AhmedMaher06/Basics-of-MCTA-Project/Mechanical/Shooting Mechanism/Shooting Mechanism.png

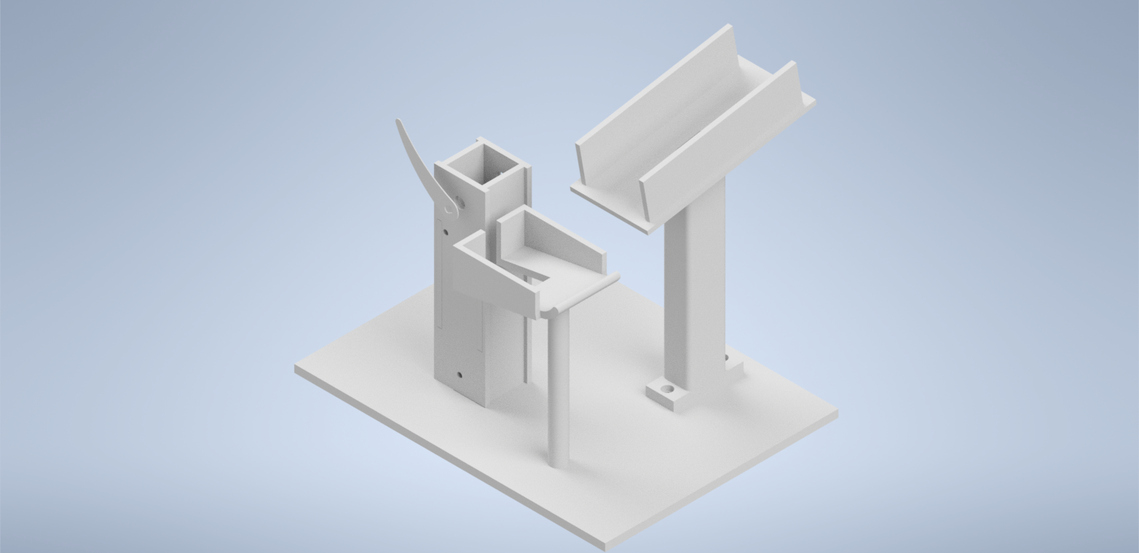
Mechanical/Shooting Mechanism/Shooting Mechanism.png
