AhmedMaher06/Basics-of-MCTA-Project/Docs/Gantt-Chart.png

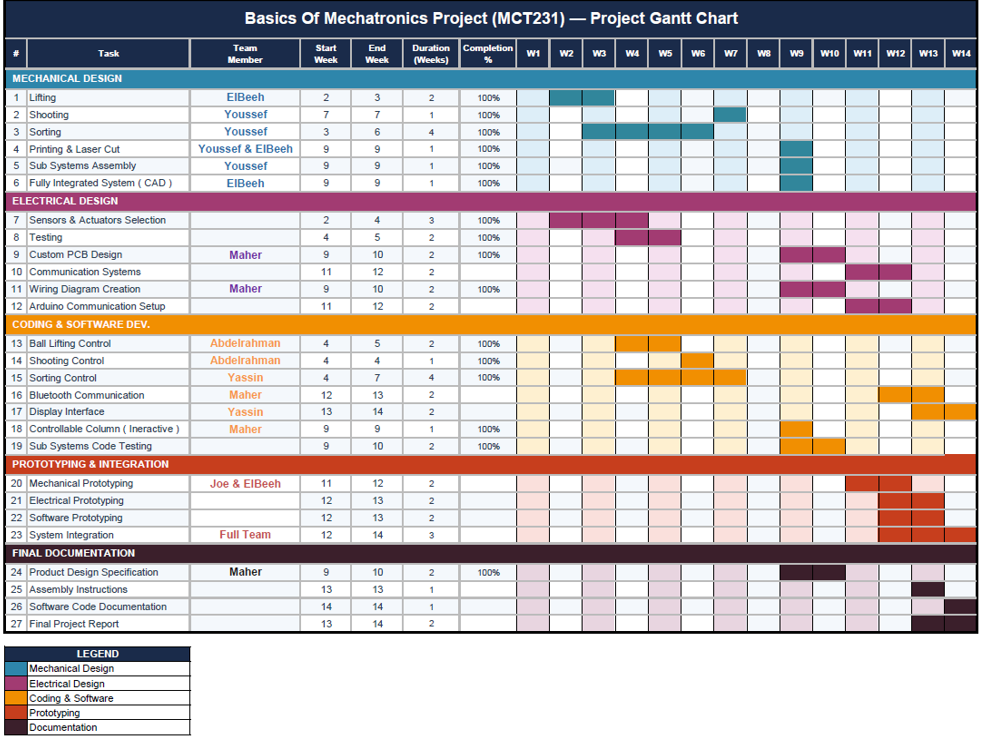
Docs/Gantt-Chart.png
