AhmedMaher06/Basics-of-MCTA-Project/README.md

# basics-project-
project basics of mechatronics
