AhmedMaher06/Basics-of-MCTA-Project/Docs/Final Report Basics Of MCTA.pdf

MCT231: Basics of Mechatronics

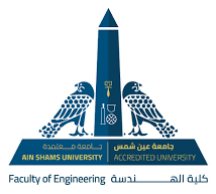
[picture p14: figure]

## MCT231: Basics of Mechatronics

# Team 7

Team Member | Student ID
Youssef Ibrahim | 24P0015
Abdelrhman Essam | 24P0045
Abdelrahman ElBeeh | 24P0114
Ahmed Maher | 24P0004
Yassin Ibrahim | 24P0162

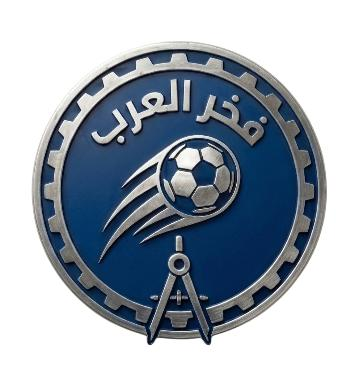
[picture p15: figure]

## Table of Contents

## Table of Figures

## 1. Introduction

This project presents a mechatronics-based interactive game designed for children, combining mechanical systems, control, and basic physics principles. The system uses a ball-based mechanism where balls are launched, lifted, and guided through a structured path. The objective of the game is to engage users in a fun and educational way while introducing them to concepts such as motion, control, and decision-making.

The game incorporates multiple subsystems including a shooting mechanism, a lifting mechanism, and a sorting/scoring section. These elements work together to create a dynamic and interactive environment that enhances both entertainment and learning.

## Project Overview & Concept

The project is a smart mechanical game that uses two types of balls:

- White balls → increase the player's score
- Black balls → decrease the player's score

The system begins with a feeding unit that releases balls into a shooting mechanism, which launches the ball along a defined path. The ball is then transferred through a lifting mechanism that elevates it to a higher level, allowing it to continue its motion through the system.

At the final stage, the ball reaches a decision area controlled by a movable slider (cylinder) operated by the player. The player must adjust the slider position to guide the ball into the desired path based on its colour: directing a white ball to the correct slot increases the score, while directing a black ball incorrectly reduces the score. This introduces an element of timing, control, and quick decision-making, making the game both challenging and engaging.

## Concept and Objectives

The main concept of the project is to integrate mechanical motion with user interaction to create a responsive system. The objectives include:

- Designing a fully integrated mechatronic system
- Demonstrating projectile motion and ball dynamics

- Developing mechanical mechanisms (shooting, lifting, guiding)
- Enhancing user interaction and reflex-based decision-making
- Creating an educational and entertaining game for children

## 2. User Research

## Research Methodology

Before finalising the toy concept, the team conducted a structured user research phase to validate the design direction. The research aimed to identify what children aged 2–10 and their parents value most in an interactive toy, and to understand the competitive landscape of educational mechatronic toys.

## Competitive Analysis

Existing toys included marble-run sets, pinball machines, and simple robotic kits. Key gaps identified:

- Most toys lack real-time scoring feedback.
- Few toys combine a colour-sensing decision mechanic with physical launching.
- Higher-end STEM toys exceed the target price point for most families.
These findings directly shaped the final concept: an affordable, colour-sorting ball game with a live score display, enclosed wiring, and no small detachable parts.

## 3. Design Challenge

The central design challenge was to create a mechatronic toy that is simultaneously safe for young children, educationally meaningful, mechanically reliable, and manufacturable within a budget of approximately 14,000 L.E.

## Key Constraints

- Safety: no exposed electrical contacts, no sharp corners, ball diameter large enough to prevent choking (≥ 30 mm).
- Size: overall footprint ≤ 100 cm × 100 cm, height ≤ 80 cm.
- Cost: primary structure from 3D-printed PLA and laser-cut plywood.
- Complexity: must be understandable and maintainable by a non-specialist adult.
- Durability: designed to survive repeated use and occasional impacts from young children.

## Identified Trade-offs

The team had to balance several competing demands throughout the design process:

- Sorting speed vs. detection accuracy: faster movement of the slider increases excitement but reduces the window for the IR to read the ball correctly.
- Compactness vs. mechanism clearance: a smaller footprint limits the travel length available for the lifting screw and the projectile range of the shooting arm.
- Motor power vs. noise: higher-torque motors are noisier, which may disturb younger children or parents.
- 3D-print resolution vs. print time: finer prints give better fitment but significantly increase fabrication time.

## 4. Ideation

## Ideation Process Overview

The team used a structured diverge-then-converge approach to idea generation. Four main techniques were employed: mind mapping, mood boarding and a weighted decision matrix.

## Mind Map

Starting from the central theme 'interactive children's toy', the team branched out into four domains: Mechanisms (shooting, lifting, sorting, guiding), Electronics (sensors, microcontrollers, actuators, displays), Interaction (player input, feedback, scoring), and Safety (materials, enclosures, edge treatment). Each domain was further expanded to individual components and ideas before being pruned by feasibility.

## Mood Board

Visual references were collected from existing ball-track toys, pinball machines, factory conveyor systems, and colorful classroom learning tools. The mood board established the design language: rounded forms, bold primary colors on a dark navy/green background, visible mechanical motion, and clear score displays.

## Decision Matrix

The final concept selection used a weighted matrix scoring each concept on: Safety (30%), Educational Value (25%), Feasibility (25%), and Engagement (20%). This concept scored highest overall (4.1/5), confirming the team's preferred direction.

## 5. Toy Description and Functionality

## 5.1 Mechanical Elements

The toy consists of three primary mechanical subsystems: the lifting mechanism, the shooting mechanism, and the sorting/guiding mechanism. All structural components are 3D-printed in PLA or laser-cut from 6 mm plywood.

Lifting Mechanism – Archimedes Screw

A helical screw (length 400 mm, outer diameter 100 mm, pitch 45 mm) transports balls from the base collection area up to the shooter entry point. The screw is driven by a DC yellow motor (stall torque 0.08–0.15 Nm). Actuator sizing confirmed the required motor torque of 0.03 Nm, well within the motor's capability. T_RMS was calculated at 0.0202 Nm for a 7-second lift cycle.

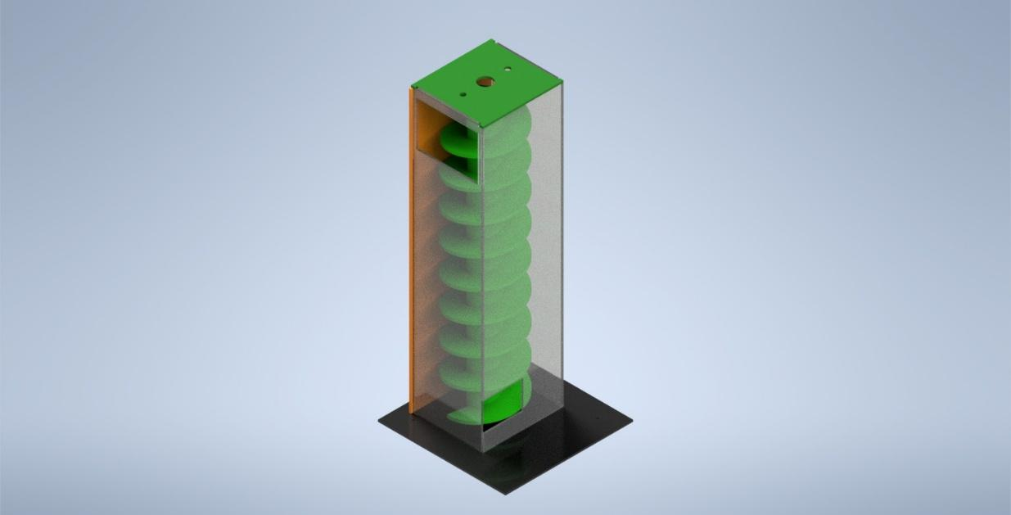
[picture p16: figure]

Figure 1 – Archimedes Screw Lifting Mechanism (Autodesk Inventor)

Shooting Mechanism – Rotating Arm

A 54 mm rotating arm (mass 3 g) is driven by a DC motor through a 180° swing in 0.2 s. The arm strikes the ball (mass 7 g, diameter 38 mm) at its tip, imparting a launch velocity of 1.13 m/s at 20° elevation. Projectile calculations give a range of 84 mm and a maximum height of 7.6 mm. Required Tm = 2.01 × 10⁻³ Nm; T_RMS = 1.17 × 10⁻³ Nm.

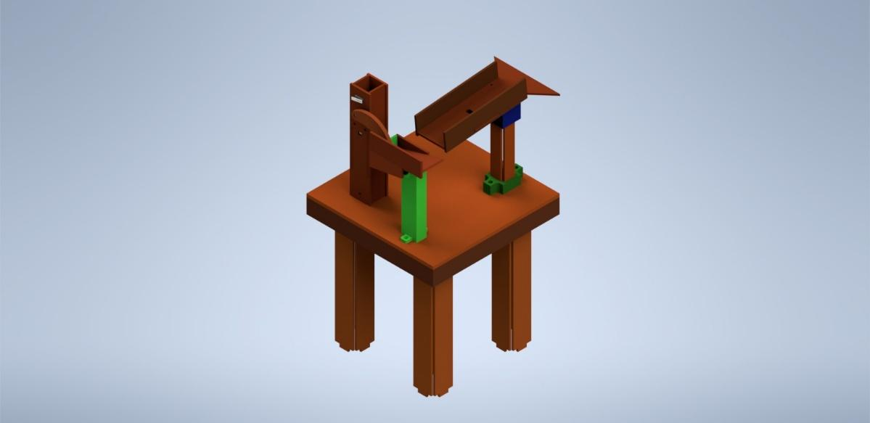
[picture p17: figure]

Figure 2 – Shooting Arm Mechanism (Autodesk Inventor)

Sorting / Guiding Mechanism – Movable Slider

A rack-and-pinion system (rack mass 4 g, travel 130 mm, pinion pitch radius 6 mm, 12 teeth) moves the decision slider horizontally in 2 s. A stepper motor provides precise positional control driven by the joystick input. T_RMS = 0.0012 Nm, well within the stepper's rated output. The slider directs each incoming ball to either a 'score' slot or a 'miss' slot based on the player's reaction to the ball's colour.

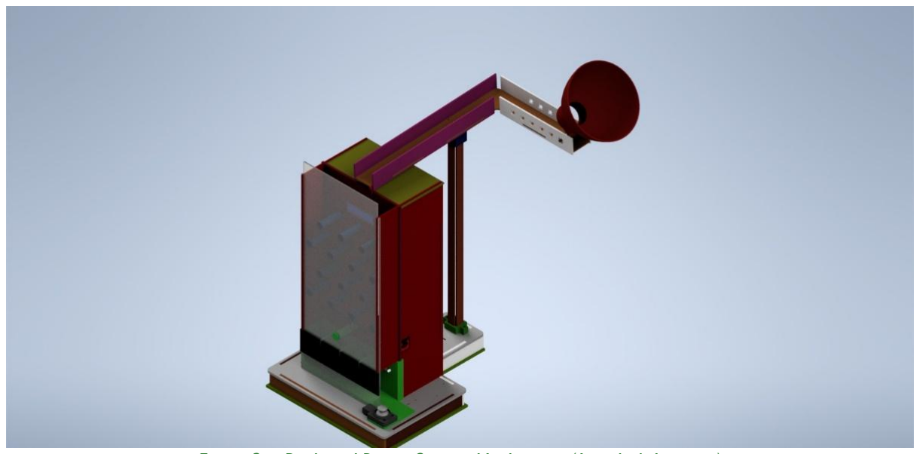
[picture p18: figure]

Figure 3 – Rack-and-Pinion Sorting Mechanism (Autodesk Inventor)

Full CAD Assembly

The complete 3D assembly was modelled in Autodesk Inventor, with overall dimensions of 94.5 cm (W) × 70 cm (L) × 72 cm (H). All mechanisms were verified for clearance and assembly fitment within the toy enclosure.

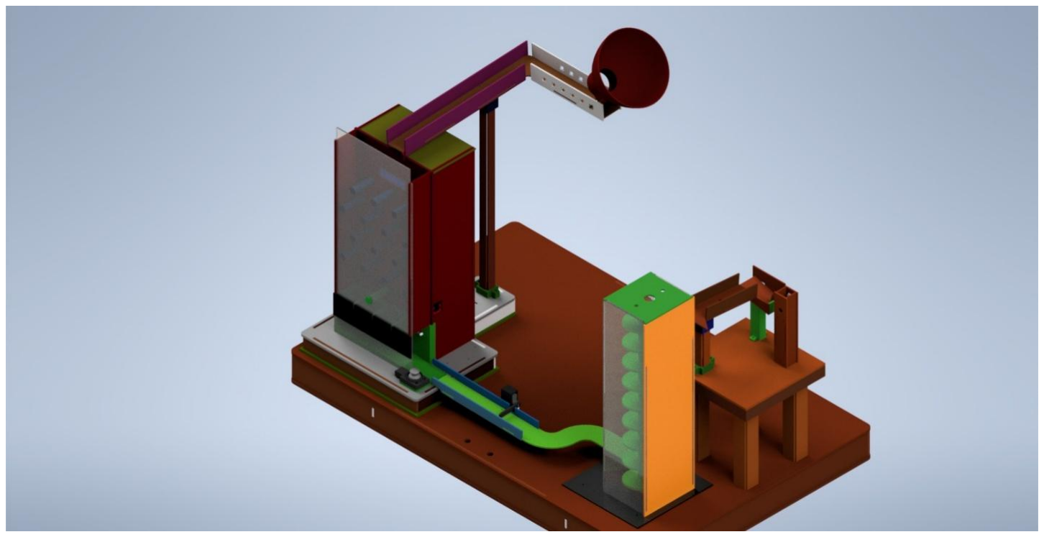
[picture p19: figure]

Figure 4 – Full System CAD Assembly (Autodesk Inventor)

## 5.2 Electrical and Control Elements

The electrical system is built around two Arduino microcontrollers communicating via a serial link. One Arduino manages the sensor inputs and shooting/lifting control; the other handles the sorting logic, display, and Bluetooth communication.

Sensor System

IR sensors (operating at 3.3–5 V, 20 mA) are placed at three critical points: (1) at the screw entry to trigger lifting, (2) at the shooter entry to confirm ball readiness, and (3) at the colour detection zone before the slider. The colour sensor distinguishes white from black balls by comparing reflected IR intensity against a threshold.

Motor Control & Wiring

Each DC motor is driven via an H-bridge driver.

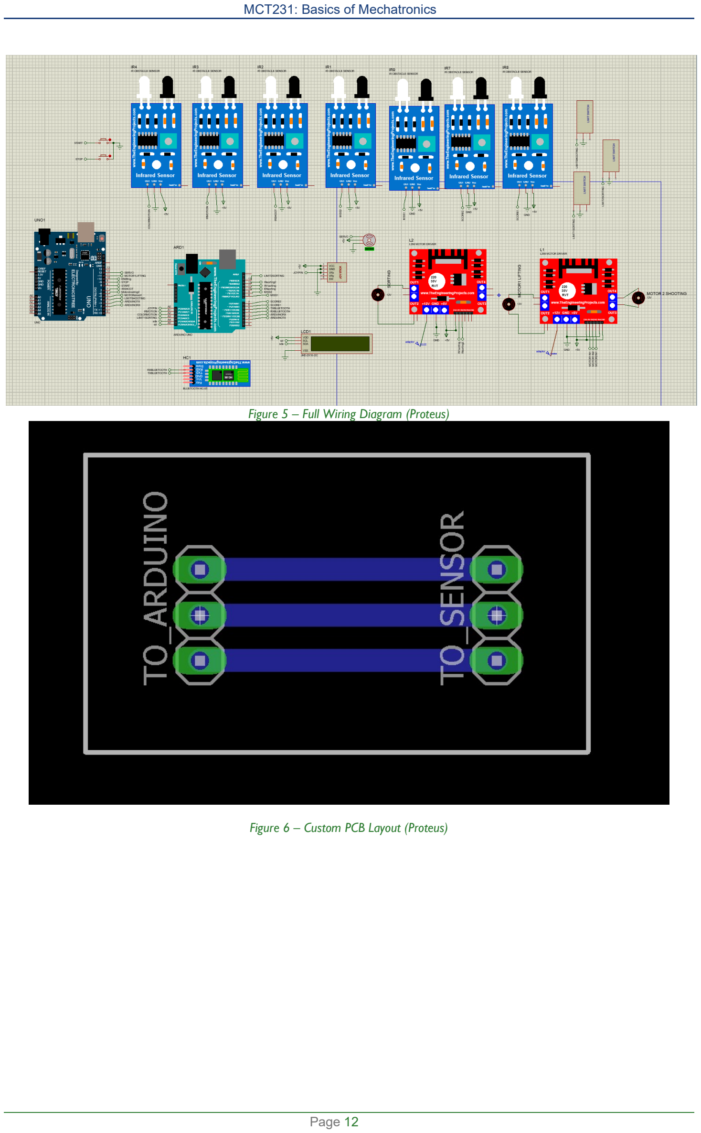
[picture p20: page 12]

Figure 5 – Full Wiring Diagram (Proteus)

Figure 6 – Custom PCB Layout (Proteus)

Block Diagram

The system block diagram illustrates the signal flow from sensors through the Arduinos to each actuator and the display. Bluetooth communication allows an optional mobile app to display real-time scores.

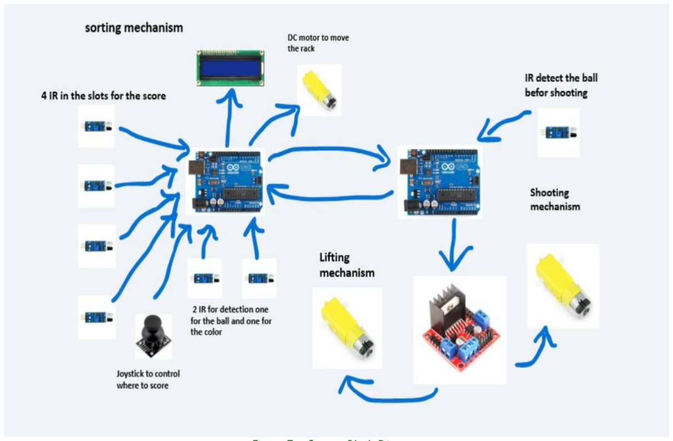
[picture p21: figure]

Figure 7 – System Block Diagram

## 6. Safety Considerations

The toy has been designed in compliance with general child product safety guidelines applicable to toys for children aged 2–10. The following specific design decisions ensure a safe user experience:

## Mechanical Safety

- All external surfaces are rounded with fillets ≥ 3 mm; no sharp edges or protruding fasteners are accessible to a child.
- Ball diameter is 30 mm — well above the 3D choke-hazard threshold of 31.7 mm for children under 3 (borderline; a slightly larger ball is recommended for the under-3 segment).
- Maximum ball launch velocity is 1.13 m/s — insufficient to cause injury on skin contact at the tested range.
- The Archimedes screw is fully enclosed within a transparent polycarbonate tube to prevent finger insertion during operation.

## Electrical Safety

- All wiring is routed internally and secured with cable ties; no bare conductors are accessible from outside the housing.
- All electrical components are housed.
- The operating voltage is 12 V DC supplied by a wall adapter; no mains-level voltages are present inside the toy.
- PCB safety circuits prevent motor overload and short-circuit conditions.

## Material Safety

- PLA plastic (used for 3D-printed parts) is biodegradable and non-toxic.
- Laser-cut plywood edges are sanded and sealed to prevent splinters.

## 7. Educational Impact

The toy is designed to develop a range of cognitive and physical skills appropriate for children aged 2–10, while keeping the experience fun and self-motivating through the score-based reward system.

## Cognitive Development

- Colour Recognition: children must rapidly identify ball colour (white or black) and make a decision — strengthening colour discrimination and pattern recognition.
- Cause and Effect: the direct link between slider position and ball routing builds logical reasoning; children observe that their choice has a measurable, scored consequence.
- Numerical Literacy: the LCD score display introduces basic counting and positive/negative number concepts in a game context.
- Attention and Concentration: the time-limited nature of each ball cycle demands sustained focus and improves attention span over repeated play sessions.

## Motor Skills

- Fine Motor Control: joystick manipulation to position the slider precisely develops hand-eye coordination and fine motor dexterity.
- Reaction Time: the shooting interval trains reflex responses; with practice, children improve their timing and accuracy.

## Introduction to STEM Concepts

- Physics: visible ball trajectory illustrates projectile motion, gravity, and energy transfer in an intuitive, hands-on way.
- Electronics Awareness: the presence of sensors, displays, and motors in a transparent or partially-visible enclosure demystifies technology for young users.
- System Thinking: the three-stage sequence (lift → shoot → sort) exposes children to the concept of interconnected subsystems working together.
Overall, the toy bridges play and education, encouraging children to think, react, and improve with every session — aligning with modern STEM education goals.

## 8. Work Breakdown Structure (WBS)

The following WBS outlines all major tasks from concept to final documentation. Each level represents a decomposition of project scope into manageable work packages.

## Level 1 – Project Overview

- 1.1 Conceptual Design
- 1.1.1 Define user needs and project scope
- 1.1.2 Research similar projects for inspiration
- 1.1.3 Sketch the overall design

## Level 2 – Mechanical Design

- 1.2.1 Lifting Mechanism Design
- 1.2.2 Shooting Mechanism Design
- 1.2.3 Sorting Mechanism Design
- 1.2.4 System Assembly Design

## Level 3 – Electrical Design

- 1.3.1 Sensor Integration
- 1.3.2 Display System
- 1.3.3 Custom PCB Design
- 1.3.4 Communication Systems (Bluetooth)
- 1.3.5 Wiring Diagram Creation
- 1.3.6 Arduino Communication Setup

## Level 4 – Software Development

- 1.4.1 Ball Lifting Control
- 1.4.2 Shooting Control
- 1.4.3 Sorting Control
- 1.4.4 Bluetooth Communication
- 1.4.5 Display Interface
- 1.4.6 Controllable Column
- 1.4.7 Arduino Communication Code

## Level 5 – Prototyping & Integration

- 1.5.1 Mechanical Prototyping
- 1.5.2 Electrical Prototyping
- 1.5.3 System Integration

## Level 6 – Testing & Optimization

- 1.6.1 Prototype Testing
- 1.6.2 Scoring System Testing

## Level 7 – Final Documentation

- 1.7.1 Product Design Specification (PDS)
- 1.7.2 Assembly Instructions
- 1.7.3 Software Code Documentation
- 1.7.4 Final Project Report

## 9. Product Design Specifications (PDS)

Specification Category | Details
Product Overview | Interactive mechatronic toy for children aged 2–10. Integrates shooting, sorting, and lifting mechanisms.
Performance | Three key functions: (1) projectile shooting, (2) Archimedes screw lifting, (3) colour-based sorting. Includes score/miss slots and live score display.
Cost | ~14,000 L.E. (3D-printed parts + laser-cut wood + electronic components)
Customers | Children aged 2–10 and their parents/educators.
Safety | No sharp edges, no small detachable parts. All electronics enclosed in child-safe housing, wiring hidden internally.
Mechanical Functionality | DC motor shoots the ball. Archimedes screw lifts ball (DC motor). Sorting via IR sensor + stepper-driven slider.
Electrical Integration | Sensors detect ball colour and position; signals processed by Arduino; motors controlled via H-bridge and stepper driver.
Software Control | Arduino manages sensor input, motor actuation, sorting logic, display, and Bluetooth communication with mobile app.
Manufacture | 3D-printed PLA parts + laser-cut plywood. Electronic components purchased off-the-shelf.
Size | 94.5 cm (W) × 70 cm (L) × 72 cm (H). Weight is suitable for adult-assisted child use.
Aesthetic | Colourful, rounded, child-friendly design. Dark navy and grass-green colour scheme with transparent acrylic panels.
Maintenance | Easily replaceable parts; clean internal wiring layout for serviceability.
Working Voltage / Current | IR sensor: 3.3–5 V, 20 mA | DC motor: 4–9 V, 190 mA (no load) |

## 10. Actuator Sizing

This section presents the complete actuator sizing calculations for all three subsystems: the Lifting Mechanism (Archimedes screw), the Shooting Mechanism (rotating arm), and the Sorting Mechanism (rack-and-pinion slider). A trapezoidal motion profile is used throughout.

## 10.1 Lifting Mechanism – Actuator Sizing

General Equation
J_total * theta_double_dot = Tm - Tr Therefore: Tm = J_total * theta_double_dot + Tr

Parameters
- Screw mass = 0.3 kg
- Outer diameter = 100 mm → radius = 0.05 m
- Length = 0.4 m
- Pitch = 0.045 m/rev
- Ball mass = 0.007 kg

Inertia of the Screw
J = (1/2) * m * r^2
J = (1/2) * (0.30) * (0.05)^2
J = 0.000375 kg·m² = 3.75 × 10⁻⁴ kg·m²

Target Speed & Acceleration
Target speed is 100 rpm; the yellow motor reaches this speed in 0.5 s.

omega = (2 * pi * 100) / 60 = 10.47 rad/s alpha = omega / t_accel = 10.47 / 0.5 = 20.94 rad/s²

Torque Required at the Screw
The force on the ball and the resistance torque (using screw efficiency η = 30%):

F_ball = m * g = 0.007 × 9.81 = 0.0687 N
Tr = F / (2 * pi * eta * P) = 0.0687 / (2 * π * 0.3 * 0.045) Tr = 1.6 × 10⁻³ Nm ≈ 0.02 Nm

Motor Selection Check
Tm = J_total * alpha + Tr
Tm = (3.75 × 10⁻⁴) * (20.94) + 0.02

Tm = 0.0278 Nm ≈ 0.03 Nm
The yellow motor provides 0.08 – 0.15 Nm stall torque. Required Tm = 0.03 Nm → Motor is SUITABLE.

## 10.2 T_RMS Calculations – Lifting Mechanism

Parameters
- Lift distance = 0.4 m, Total time = 7 s
- Pitch = 0.045 m/rev, J_screw = 3.75 × 10⁻⁴ kg·m², Tr = 0.02 Nm

Total Revolutions & Angular Distance
N = 0.4 / 0.045 = 8.89 rev theta_total = 8.89 * (2 * pi) = 55.85 rad

Trapezoidal Motion Profile
- Acceleration phase: ta = 1.75 s (25% of profile)
- Constant-speed phase: tc = 3.5 s (50% of profile)
- Deceleration phase: td = 1.75 s (25% of profile)

Maximum Angular Speed
theta = omega_max * (tc + (ta + td) / 2) 55.85 = omega_max * (3.5 + 1.75) omega_max = 55.85 / 5.25 = 10.64 rad/s

Angular Acceleration

alpha = omega_max / ta = 10.64 / 1.75 = 6.08 rad/s²

Torque Analysis
Ta = J * alpha + Tr = (3.75×10⁻⁴)(6.08) + 0.02 = 0.0223 Nm
Tc = Tr | = 0.0200 Nm
Td = Tr - J * alpha = 0.02 - (3.75×10⁻⁴)(6.08) = 0.0177 Nm

Final T_RMS
T_RMS = sqrt[ (Ta² * ta + Tc² * tc + Td² * td) / T_total ] T_RMS = sqrt[ (0.0223² × 1.75 + 0.02² × 3.5 + 0.0177² × 1.75) / 7 ] T_RMS = 0.0202 Nm

## 10.3 Shooting Mechanism – Actuator Sizing

Parameters
- Arm: Length = 54 mm = 0.054 m, Mass = 3 g = 0.003 kg
- Ball: Diameter = 3 cm, Mass = 7 g = 0.007 kg
- Motion: Rotation angle = 180° = π rad, Total move time = 0.2 s
- Profile times: ta = 0.05 s, tc = 0.10 s, td = 0.05 s

Maximum Angular Speed
theta = omega_max * (tc + (ta + td) / 2) pi = omega_max * (0.10 + 0.05) omega_max = pi / 0.15 = 20.94 rad/s

Angular Acceleration
alpha = omega_max / ta = 20.94 / 0.05 = 418.9 rad/s²

Arm Inertia & Resistance Torque J_arm = (1/3) * m * L² = (1/3)(0.003)(0.054)² = 2.92 × 10⁻⁶ kg·m² Tr_arm = m * g * r = (0.003)(9.81)(0.027) = 7.9 × 10⁻⁴ Nm

Motor Torque Required
Tm = J_arm * alpha + Tr_arm Tm = (2.92×10⁻⁶)(418.9) + 7.9×10⁻⁴ Tm = 2.01 × 10⁻³ Nm

T_RMS Calculations – Shooting Ta = J * alpha + Tr = 2.01 × 10⁻³ Nm
Tc = Tr | = 7.9 × 10⁻⁴ Nm
Td = Tr - J * alpha = 7.9×10⁻⁴ - (2.92×10⁻⁶ × 418.9) = -4.33×10⁻⁴ Nm

T_RMS = sqrt[ (Ta² × 0.05 + Tc² × 0.10 + Td² × 0.05) / 0.2 ] T_RMS = 1.17 × 10⁻³ Nm

## 10.4 Projectile Calculations

Launch Conditions
- Launch velocity: v = omega_max × r = 20.94 × 0.054 = 1.13 m/s
- Launch angle: theta = 20°
- Gravitational acceleration: g = 9.81 m/s²

Equations of Motion
x(t) = v * cos(theta) * t
y(t) = v * sin(theta) * t - (1/2) * g * t²

Time of Flight
t_flight = (2 * v * sin(theta)) / g t_flight = (2 * 1.13 * sin(20°)) / 9.81 = 0.079 s

Horizontal Range
x = v * cos(theta) * t = 1.13 * cos(20°) * 0.079 = 0.084 m = 84 mm

Maximum Height
H_max = (v² * sin²(theta)) / (2 * g) H_max = (1.13² * sin²(20°)) / (2 * 9.81) = 0.0076 m = 7.6 mm

## 10.5 Sorting Mechanism – Actuator Sizing

Parameters
- Rack load: mass = 0.004 kg, travel distance = 0.13 m, total time = 2 s
- Pinion: 12 teeth, pitch radius r = 0.006 m
- Profile: ta = 0.5 s, tc = 1.0 s, td = 0.5 s

Linear Speed & Acceleration
x = v_max * (tc + (ta + td) / 2)
0.13 = v_max * (1.0 + 0.5) => v_max = 0.0867 m/s a = v_max / ta = 0.0867 / 0.5 = 0.173 m/s²

Angular Motion at Pinion
omega = v / r_pinion = 0.0867 / 0.006 = 14.45 rad/s alpha = a / r = 0.173 / 0.006 = 28.83 rad/s²

Inertia Calculations
J_load = m * r² = (0.004)(0.006)² = 1.44 × 10⁻⁷ kg·m²
J_pinion = | 2.00 × 10⁻⁷ kg·m² (manufacturer)
J_total = 1.44×10⁻⁷ + 2.00×10⁻⁷ = 3.44 × 10⁻⁷ kg·m²

Torque Analysis
Note: Additional friction torque Tr = 0.0012 Nm due to 3D-printed surfaces (F_friction = 0.2 N assumed).
Ta = J_total * alpha + Tr = (3.44×10⁻⁷)(28.83) + 0.0012 = 0.00121 Nm
Tc = Tr | = 0.00120 Nm
Td = Tr - J_total * alpha | = 0.00119 Nm

Final T_RMS – Sorting
T_RMS = sqrt[ (Ta² × 0.5 + Tc² × 1.0 + Td² × 0.5) / 2 ] T_RMS = 0.0012 Nm

## 11. Flowchart & Gantt Chart

The system-level flowchart and the project Gantt chart are presented below.

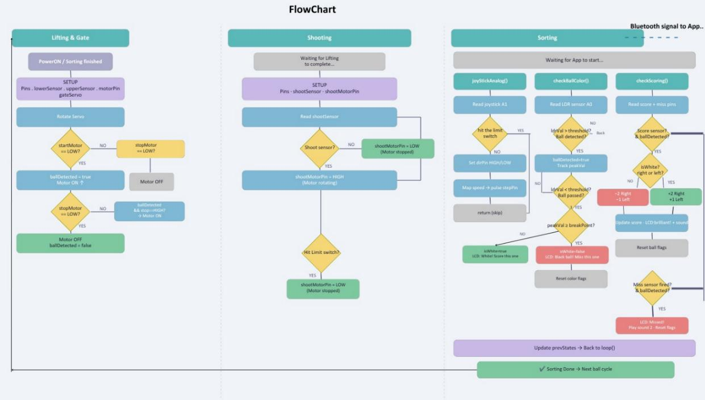
[picture p22: figure]

Figure 8 – System-Level Control Flowchart

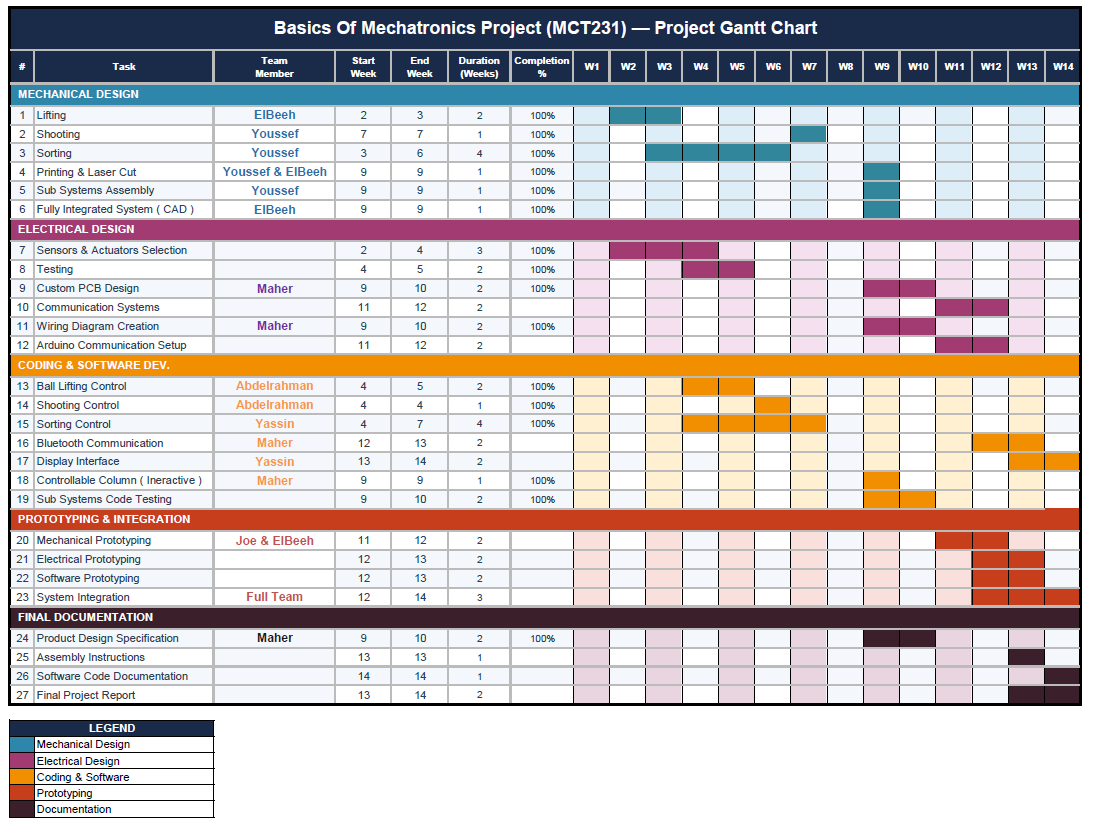
[picture p23: figure]

0

Figure 9 – Project Gantt Chart

## 12. Bill of Materials

The following tables list all components required for each subsystem. Quantities and specifications are based on the final design.

## 12.1 Lifting Subsystem

## 12.2 Shooting Subsystem

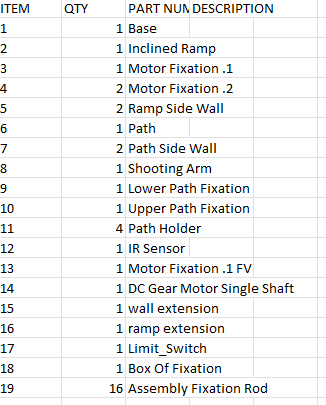
[picture p24: figure]

## 12.3 Sorting / Guiding Subsystem

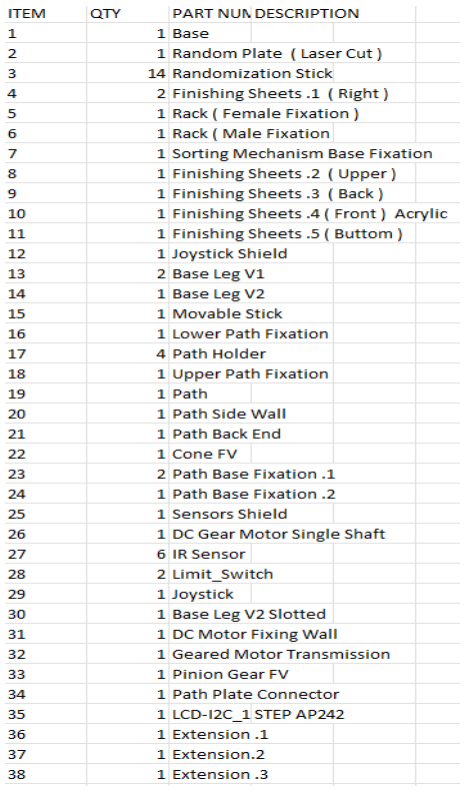
[picture p25: figure]

## 12.4 Electrical & Control Subsystem

Item | Description | Qty | Spec / Notes
Arduino Uno (×2) | Main microcontrollers | 2 | Serial communication between them
Custom PCB | Designed in Proteus; integrates drivers | 1 | H-bridge, LCD driver, Bluetooth
HC-05 Bluetooth Module | Wireless communication to mobile app | 1 | UART, 3.3 V logic
LCD Display (16×2) | Score display | 1 | I2C interface, 5 V
IR Sensors | Ball detection at multiple positions | 7 | 3.3–5 V, 20 mA each
L298N H-Bridge (×2) | DC motor driver modules | 2 | One per 2 DC motors
Power Supply / Adapter | 12 V DC wall adapter | 1 | Min 2 A, centre-positive
Joy stick | Move controllable stick | 1 | ------------------------------
Limit switch | Restricts motor travel | 3 | --------------------------
button | Start and end buttons | 2 | -----------------------

## 13. Mobile Application Screenshots

The companion mobile application (Android/iOS) connects to the toy via Bluetooth (HC-05) and provides real-time score display, session history, and system status. Representative screenshots are presented below.

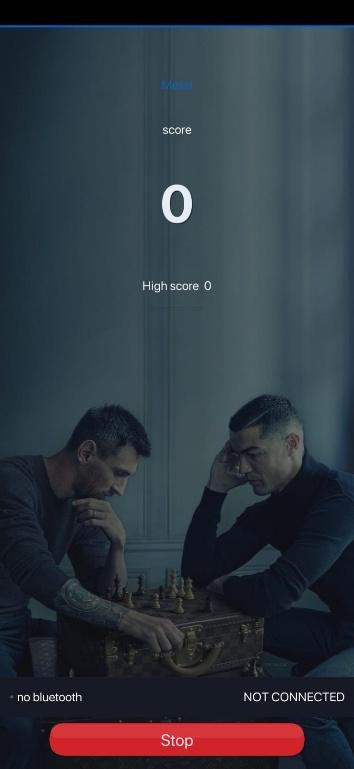
[picture p26: figure]
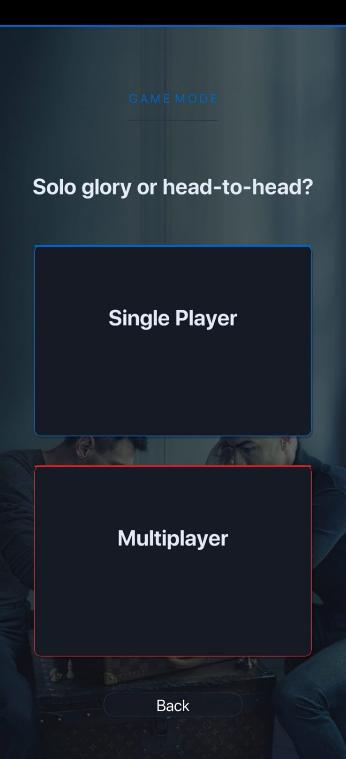
[picture p27: figure]
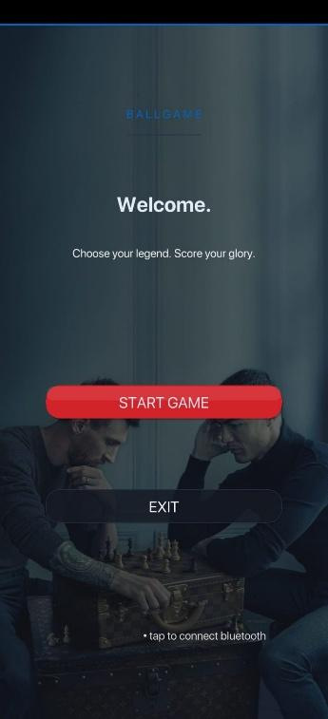
[picture p28: figure]
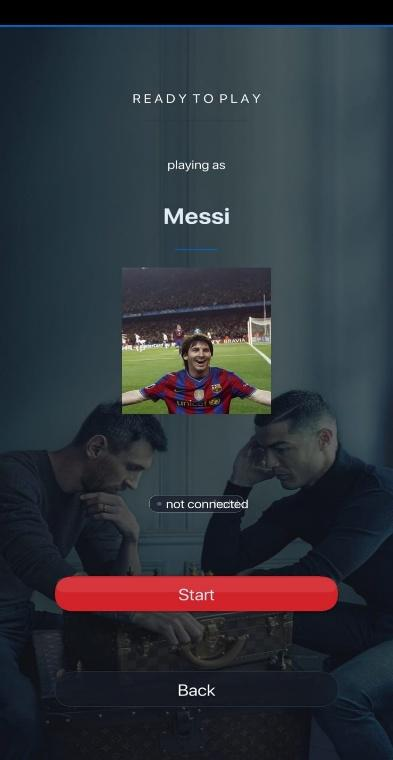
[picture p29: figure]

## 14. GitHub Repository – QR Code

All source code, CAD files, PCB designs, and documentation are hosted on the team GitHub repository. Scan the QR code below to access the repository directly.

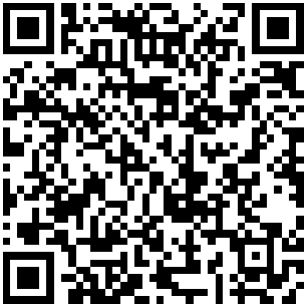
[picture p30: figure]

The repository is organised into the following folders:
- /Software
- /Mechanical
- /Electrical
- /App
- /Docs
- /Full project video

LINK FOR DEMO VIDEO
https://drive.google.com/file/d/19-VMEYYZytr9_aYip0dAZRrp6ETeBts7/view?usp=sharing (https://drive.google.com/file/d/19-VMEYYZytr9_aYip0dAZRrp6ETeBts7/view?usp=sharing)

## 15. Conclusion

This report has documented the full design, analysis, and implementation of an interactive mechatronic toy — a colour-sorting ball game — developed as part of MCT231: Basics of Mechatronics at the Faculty of Engineering, Ain Shams University.

The system successfully integrates three interdependent mechanical subsystems (Archimedes screw lifting, rotating-arm shooting, and rack-and-pinion sorting) with a dual-Arduino control architecture, custom PCB, Bluetooth connectivity, and a companion mobile application. All actuator sizing calculations confirmed that the selected DC yellow motor are well within their rated torque limits, with comfortable safety margins across all operating phases.

Key engineering outcomes achieved:
- Lifting mechanism: Required Tm = 0.03 Nm (motor rated at 0.08–0.15 Nm); T_RMS = 0.0202 Nm over a 7-second lift cycle.
- Shooting mechanism: Launch velocity of 1.13 m/s at 20° elevation yields a range of 84 mm; T_RMS = 1.17 × 10⁻³ Nm.
- Sorting mechanism: Rack-and-pinion drive achieves precise slider positioning; T_RMS = 0.0012 Nm.
- All external surfaces are child-safe, all electronics are fully enclosed, and operating voltage remains at 12 V DC.

The product meets all specifications defined in the PDS (Section 9), including the target footprint, cost estimate (~14,000 L.E.), age-group safety requirements, and educational objectives across cognitive development, motor skill training, and STEM concept introduction.
Overall, the project demonstrated the successful application of mechatronics principles — combining mechanical design, electronics, control software, and human interaction — to produce a functional, safe, and educationally valuable prototype.
