AhmedMaher06/Basics-of-MCTA-Project/Docs/Blockdiagram.jpeg

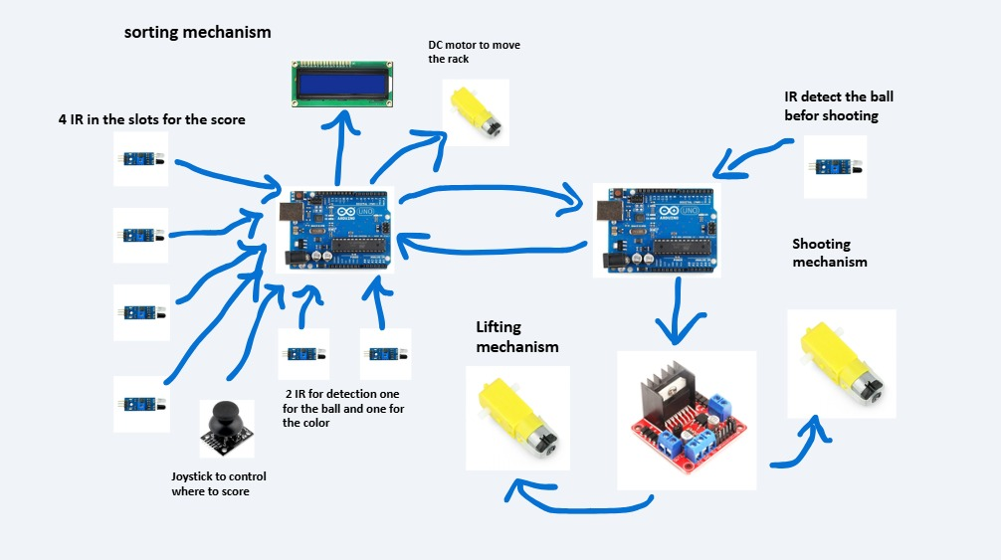
Docs/Blockdiagram.jpeg
