AhmedMaher06/Basics-of-MCTA-Project/Electrical/PCB.jpeg

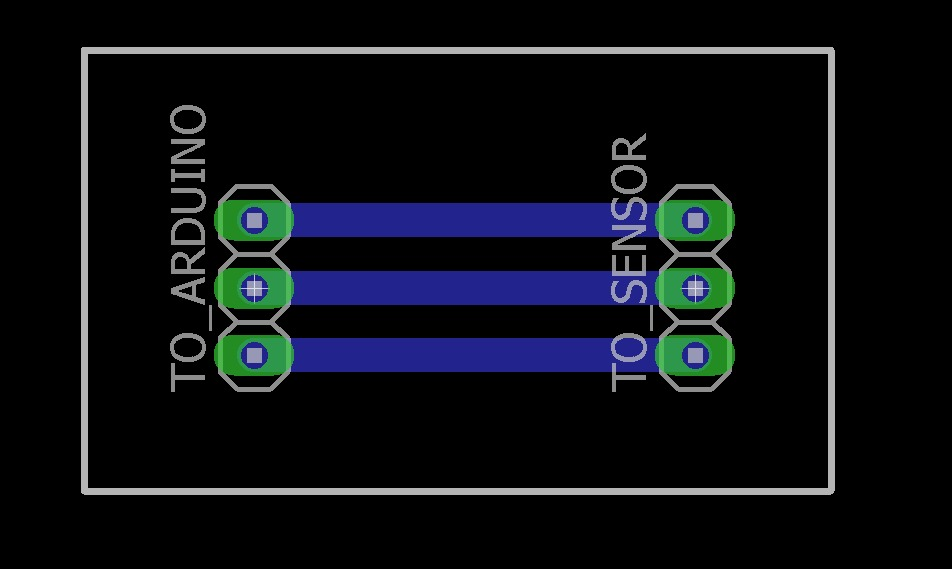
Electrical/PCB.jpeg
