AhmedMaher06/Basics-of-MCTA-Project/Mechanical/Shooting Mechanism/Shooting Mechanism Parts.pdf

ITEM | QTY | PART NUMBER | DESCRIPTION
1 | 1 | Base | Laser Cut
2 | 1 | Inclined Ramp | 3D Printing
3 | 1 | Motor Fixation .1 | Laser Cut
4 | 2 | Motor Fixation .2 | Laser Cut
5 | 2 | Ramp Side Wall | Laser Cut
6 | 1 | Path | Laser Cut
7 | 2 | Path Side Wall | Laser Cut
8 | 1 | Shooting Arm | Laser Cut
9 | 1 | Lower Path Fixation | 3D Printing
10 | 1 | Upper Path Fixation | 3D Printing
11 | 4 | Path Holder | Laser Cut
12 | 1 | IR Sensor | Standard
13 | 1 | dc motor | Standard
14 | 1 | Motor Fixation .1 FV | Laser Cut

Parts List Of Shooting Mechanism
