AhmedMaher06/Basics-of-MCTA-Project/Mechanical/Sorting Mechanism/Sorting Mechanism Parts.pdf

ITEM | QTY | PART NUMBER | DESCRIPTION
1 | 1 | Base | 3D Printing
2 | 1 | Random Plate ( Laser Cut ) | Laser Cut
3 | 14 | Randomization Stick | 3D Printing
4 | 2 | Finishing Sheets .1 ( Right ) | Laser Cut
5 | 1 | Rack ( Female Fixation ) | 3D Printing
6 | 1 | Rack ( Male Fixation | 3D Printing
7 | 1 | Stepper Simulation
8 | 1 | Stepper Shaft | 3D Printing
9 | 1 | Sorting Mechanism Base Fixation | Laser Cut
10 | 1 | Finishing Sheets .2 ( Upper ) | Laser Cut
11 | 1 | Finishing Sheets .3 ( Back ) | Laser Cut
12 | 1 | Finishing Sheets .4 ( Front ) Acrylic | Laser Cut
13 | 1 | Finishing Sheets .5 ( Buttom ) | Laser Cut
14 | 1 | Joystick Shield | 3D Printing
15 | 2 | Base Leg V1 | Laser Cut
16 | 2 | Base Leg V2 | Laser Cut
17 | 1 | Movable Stick | 3D Printing
18 | 1 | Lower Path Fixation | 3D Printing
19 | 4 | Path Holder | Laser Cut
20 | 1 | Upper Path Fixation | 3D Printing
21 | 1 | Path | Laser Cut
22 | 2 | Path Side Wall | Laser Cut
23 | 1 | Path Back End | Laser Cut
24 | 1 | Cone FV | 3D Printing
25 | 2 | Path Base Fixation .1 | Laser Cut
26 | 1 | Path Base Fixation .2 | Laser Cut
27 | 1 | Pinion Gear | Laser Cut

## Sorting Mechanism Parts
