AhmedMaher06/Basics-of-MCTA-Project/Mechanical/Fully Integrated CAD/MS18 MIZUEI SERVO 9G.step

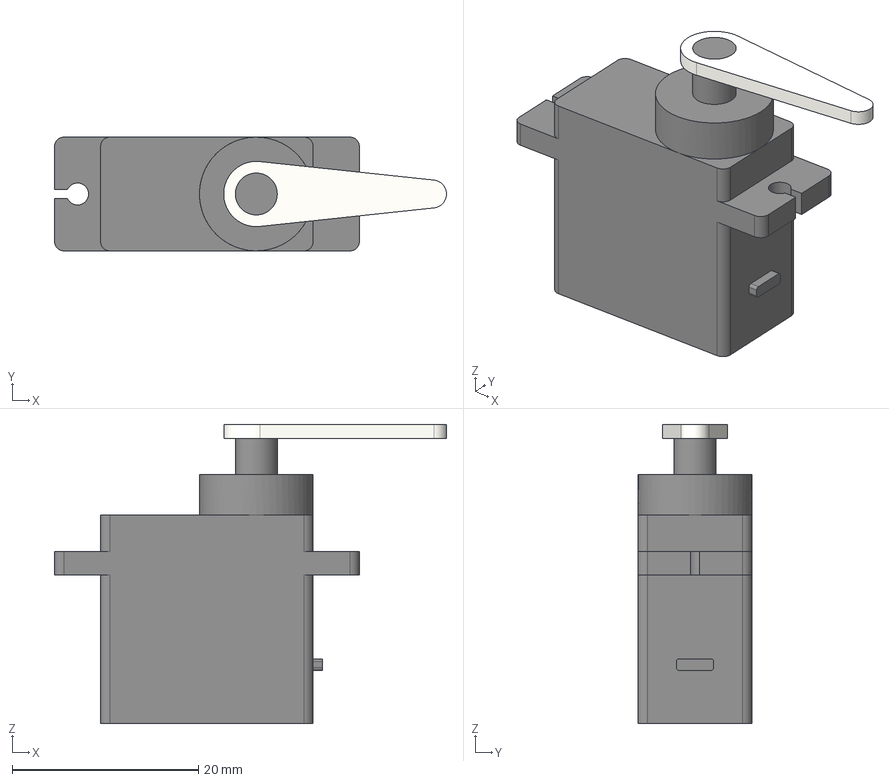
[picture p33: CAD file, 2026-06-11]
Mechanical/Fully Integrated CAD/MS18 MIZUEI SERVO 9G.step
42.1 x 12.2 x 32.1 mm
