AhmedMaher06/Basics-of-MCTA-Project/Mechanical/Shooting Mechanism/Limit_Switch.SLDPRT

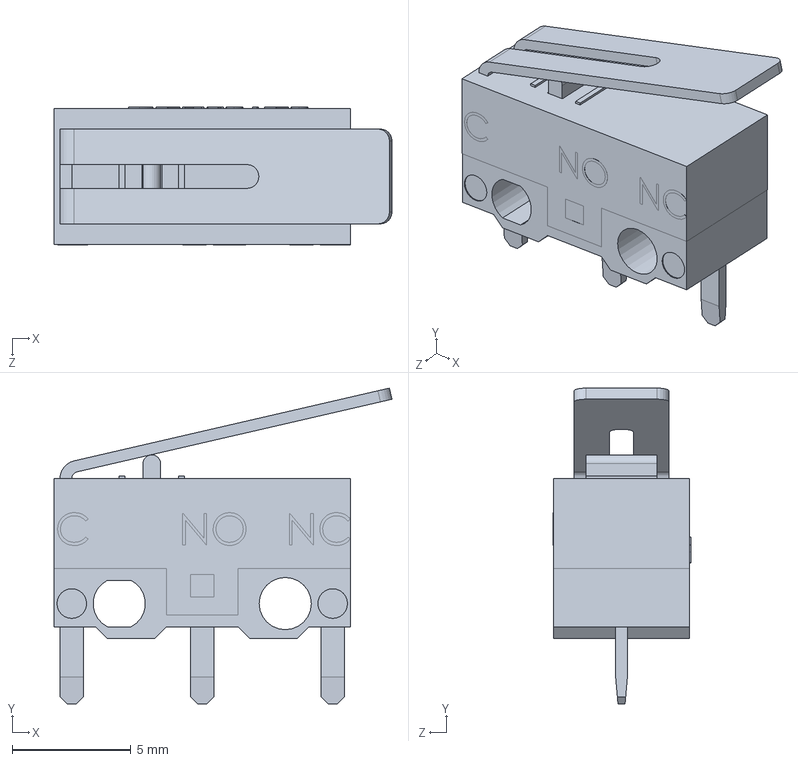
[picture p34: CAD file, 2026-06-11]
Mechanical/Shooting Mechanism/Limit_Switch.SLDPRT
14.2 x 13.3 x 5.81 mm
