AhmedMaher06/Basics-of-MCTA-Project/Mechanical/Shooting Mechanism/DC Gear Motor Single Shaft.SLDPRT

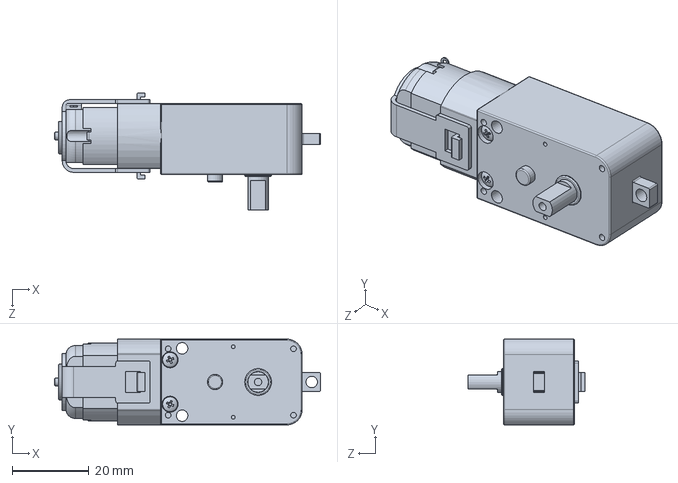
[picture p35: CAD file, 2026-06-11]
Mechanical/Shooting Mechanism/DC Gear Motor Single Shaft.SLDPRT
69.5 x 22.4 x 30.5 mm
