AhmedMaher06/Basics-of-MCTA-Project/Mechanical/Sorting Mechanism/Joystick.SLDPRT

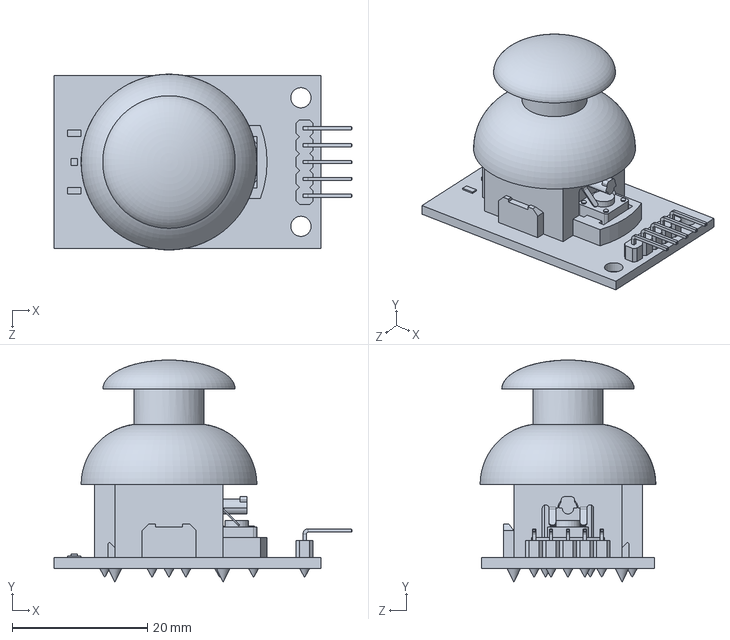
[picture p36: CAD file, 2026-06-11]
Mechanical/Sorting Mechanism/Joystick.SLDPRT
44.0 x 32.8 x 26.0 mm
