AhmedMaher06/Basics-of-MCTA-Project/(list of files, cad)

Other CAD files:
Mechanical/Shooting Mechanism/Shooting Assembly Construction DWG.dwg
Mechanical/Sorting Mechanism/Sorting Mechanism DWG.dwg
Mechanical/Sorting Mechanism/Rack & Pinion Laser.dwg
Mechanical/Fully Integrated CAD/3D Printing.ipt
Mechanical/Fully Integrated CAD/Ball.ipt
Mechanical/Fully Integrated CAD/Base Full Game.ipt
Mechanical/Fully Integrated CAD/Fully Integrated CAD System.iam
Mechanical/Fully Integrated CAD/Servo Arm.ipt
Mechanical/Fully Integrated CAD/Servo Housing.ipt
Mechanical/Fully Integrated CAD/Starting Path Wall ( Servo ).ipt
Mechanical/Fully Integrated CAD/Starting Path Wall.ipt
Mechanical/Fully Integrated CAD/Starting Path.ipt
Mechanical/Fully Integrated CAD/Table-Base Fixation ( Power Port ).ipt
Mechanical/Fully Integrated CAD/Table-Base Fixation 2nd.ipt
Mechanical/Fully Integrated CAD/Table-Base Fixation.ipt
Mechanical/Fully Integrated CAD/Table-Base Supporter 1st.ipt
Mechanical/Fully Integrated CAD/Table.ipt
Mechanical/Lifting Mechanism/Assembly2.iam
Mechanical/Lifting Mechanism/Lift cover of lifting.ipt
Mechanical/Lifting Mechanism/Lifting mechanism.ipt
Mechanical/Lifting Mechanism/Part 1 base.ipt
Mechanical/Lifting Mechanism/Part1.ipt
Mechanical/Lifting Mechanism/ackleryk.ipt
Mechanical/Lifting Mechanism/back support.ipt
Mechanical/Lifting Mechanism/lifting cover 2.ipt
Mechanical/Lifting Mechanism/lifting cover.ipt
Mechanical/Lifting Mechanism/upper support.ipt
Mechanical/Shooting Mechanism/Assembly Fixation Rod.ipt
Mechanical/Shooting Mechanism/Base.ipt
Mechanical/Shooting Mechanism/Box Of Fixation.ipt
Mechanical/Shooting Mechanism/Inclined Ramp.ipt
Mechanical/Shooting Mechanism/Lower Path Fixation Shooting.ipt
Mechanical/Shooting Mechanism/Motor Fixation .1 FV.ipt
Mechanical/Shooting Mechanism/Motor Fixation .1.ipt
Mechanical/Shooting Mechanism/Motor Fixation .2.ipt
Mechanical/Shooting Mechanism/Path Holder Shooting.ipt
Mechanical/Shooting Mechanism/Path Holder V1.ipt
Mechanical/Shooting Mechanism/Path Side Wall.ipt
Mechanical/Shooting Mechanism/Path.ipt
Mechanical/Shooting Mechanism/Ramp Side Wall.ipt
Mechanical/Shooting Mechanism/Shooting Arm V2.ipt
Mechanical/Shooting Mechanism/Shooting Arm.ipt
Mechanical/Shooting Mechanism/Shooting Assembly FV.iam
Mechanical/Shooting Mechanism/Shooting Assembly.iam
Mechanical/Shooting Mechanism/Upper Path Fixation Shooting.ipt
Mechanical/Shooting Mechanism/dc motor.ipt
Mechanical/Shooting Mechanism/ramp extension.ipt
Mechanical/Shooting Mechanism/wall extension.ipt
Mechanical/Sorting Mechanism/Base Leg V1.ipt
Mechanical/Sorting Mechanism/Base Leg V2 Slotted.ipt
Mechanical/Sorting Mechanism/Base Leg V2.ipt
Mechanical/Sorting Mechanism/Base.ipt
Mechanical/Sorting Mechanism/Cone FV.ipt
Mechanical/Sorting Mechanism/Cone Shape.ipt
Mechanical/Sorting Mechanism/Cone Support.ipt
Mechanical/Sorting Mechanism/DC Motor Fixation.ipt
Mechanical/Sorting Mechanism/DC Motor Fixing Wall.ipt
Mechanical/Sorting Mechanism/Extension .1.ipt
Mechanical/Sorting Mechanism/Extension .3.ipt
Mechanical/Sorting Mechanism/Extension.2.ipt
Mechanical/Sorting Mechanism/Finishing Sheets .1 ( Right ).ipt
Mechanical/Sorting Mechanism/Finishing Sheets .2 ( Upper ).ipt
Mechanical/Sorting Mechanism/Finishing Sheets .3 ( Back ).ipt
Mechanical/Sorting Mechanism/Finishing Sheets .4 ( Front ) Acrylic.ipt
Mechanical/Sorting Mechanism/Finishing Sheets .5 ( Buttom ).ipt
Mechanical/Sorting Mechanism/Geared Motor Transmission.ipt
Mechanical/Sorting Mechanism/Joystick Shield.ipt
Mechanical/Sorting Mechanism/Lower Path Fixation.ipt
Mechanical/Sorting Mechanism/MINI Stepper Shaft ( Pinion ).ipt
Mechanical/Sorting Mechanism/Movable Stick Fixation.ipt
Mechanical/Sorting Mechanism/Movable Stick.ipt
Mechanical/Sorting Mechanism/Nema 17 Stepper (42-34).ipt
Mechanical/Sorting Mechanism/Path Back End.ipt
Mechanical/Sorting Mechanism/Path Base Fixation .1.ipt
Mechanical/Sorting Mechanism/Path Base Fixation .2.ipt
Mechanical/Sorting Mechanism/Path Holder.ipt
Mechanical/Sorting Mechanism/Path Plate Connector.ipt
Mechanical/Sorting Mechanism/Path Side Wall.ipt
Mechanical/Sorting Mechanism/Path.ipt
Mechanical/Sorting Mechanism/Pinion Gear FV.ipt
Mechanical/Sorting Mechanism/Pinion Gear.ipt
Mechanical/Sorting Mechanism/Rack ( Female Fixation ).ipt
Mechanical/Sorting Mechanism/Rack ( Male Fixation.ipt
Mechanical/Sorting Mechanism/Random Plate ( Laser Cut ).ipt
Mechanical/Sorting Mechanism/Randomization Stick.ipt
Mechanical/Sorting Mechanism/Sensors Shield.ipt
Mechanical/Sorting Mechanism/Sorting Mechanism Assembly.iam
Mechanical/Sorting Mechanism/Sorting Mechanism Base Fixation.ipt
Mechanical/Sorting Mechanism/Stepper Simulation.ipt
Mechanical/Sorting Mechanism/Upper Path Fixation.ipt
Mechanical/Sorting Mechanism/Wires Input Orientation.ipt
