AhmedMaher06/Basics-of-MCTA-Project/(commit log)

2026-06-11 Rename Screenshot 2026-06-11 014403.png to Wiring_Diagram_wholeSystem.png
2026-06-11 Rename فخر العرب.png to Poster.png
